jc-cr/edge_human_detection_board/docs/coral_micro_docs/dev_board_micro/Coral-Dev-Board-Micro-Altium/PCB/ALTIUM_EMBEDDED_MODELS/1206.STEP

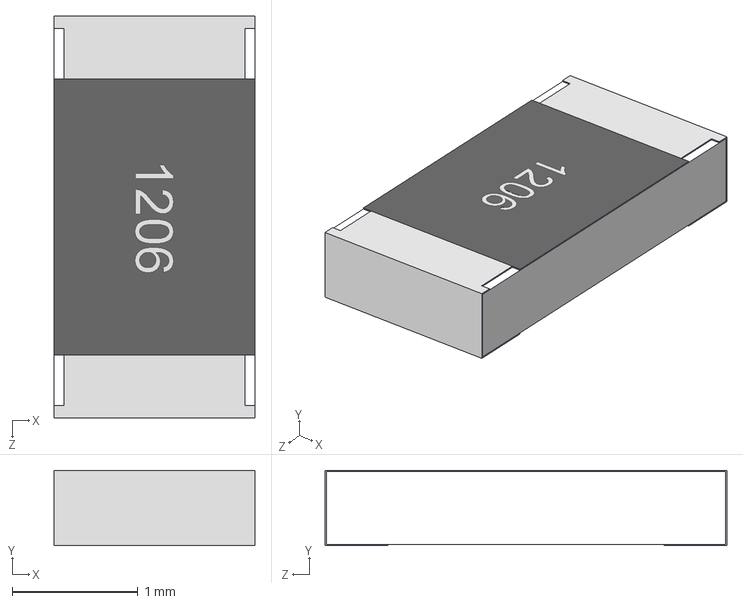
[picture p1: CAD file, 2024-11-24]
docs/coral_micro_docs/dev_board_micro/Coral-Dev-Board-Micro-Altium/PCB/ALTIUM_EMBEDDED_MODELS/1206.STEP
1.60 x 0.6 x 3.20 mm
