jc-cr/edge_human_detection_board/LIB_4684/4684/3D/4684.stp

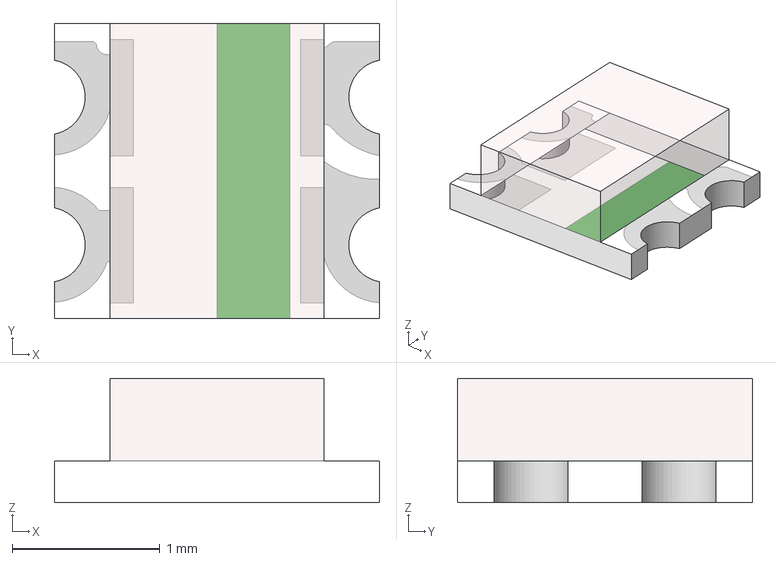
[picture p2: CAD file, 2024-12-29]
LIB_4684/4684/3D/4684.stp
2.20 x 2.00 x 0.84 mm
