jc-cr/edge_human_detection_board/LIB_VL53L8CXV0GC_1/VL53L8CXV0GC_1/3D/VL53L8CXV0GC_1.stp

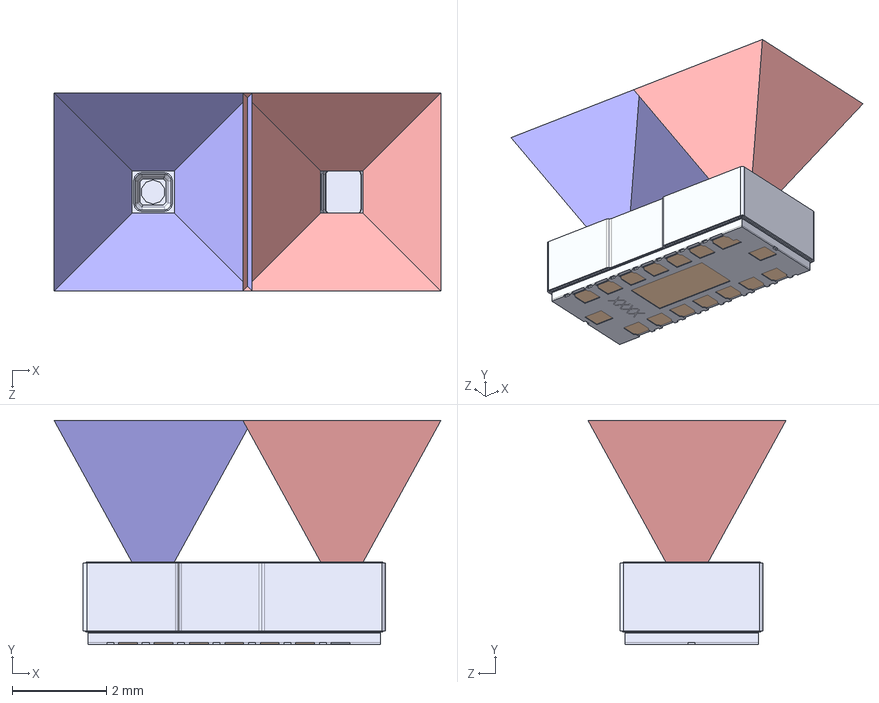
[picture p3: CAD file, 2024-12-29]
LIB_VL53L8CXV0GC_1/VL53L8CXV0GC_1/3D/VL53L8CXV0GC_1.stp
8.20 x 4.75 x 4.20 mm
VL53L8 SUBSTRATE
VL53L8 CAP
VL53L8 Rx Exclusion Cone
VL53L8 Tx Exclusion Cone
