jc-cr/edge_human_detection_board/satel-vl53l8-cad-files-step/J5866.step

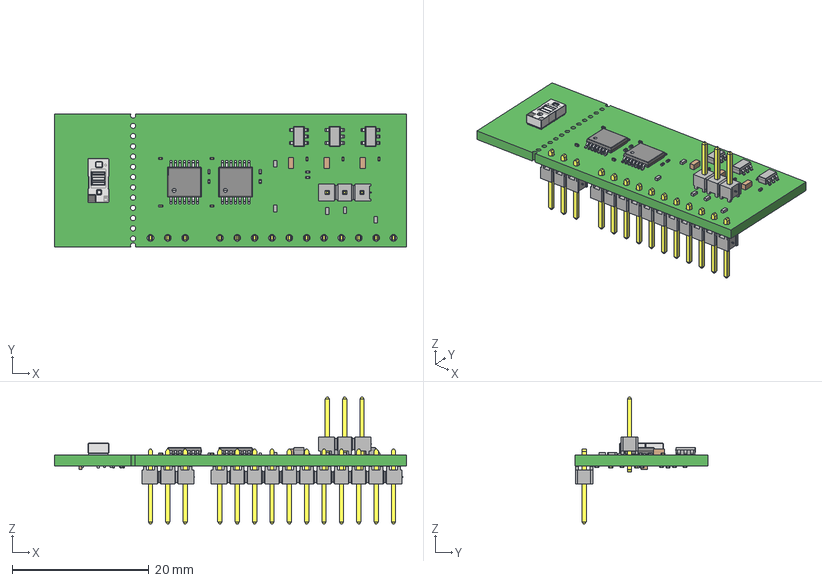
[picture p4: CAD file, 2024-11-22]
satel-vl53l8-cad-files-step/J5866.step
51.5 x 19.5 x 18.5 mm
_TSW-103-07-G-S_body x 2
_T-1S6-07-TSW-1-07-3-S x 2
Extruded x 86
User_Library-TSSOP14-1 x 2
User_Library-SOT-23-5L x 3
MZ_Plus_ES0_MODULE_ASSEMBLY
_TSW-111-07-G-S_body
_T-1S6-07-TSW-1-07-11-S
