jc-cr/edge_human_detection_board/docs/coral_micro_docs/dev_board_micro/Coral-Dev-Board-Micro-Altium/PCB/ALTIUM_EMBEDDED_MODELS/0603.STEP

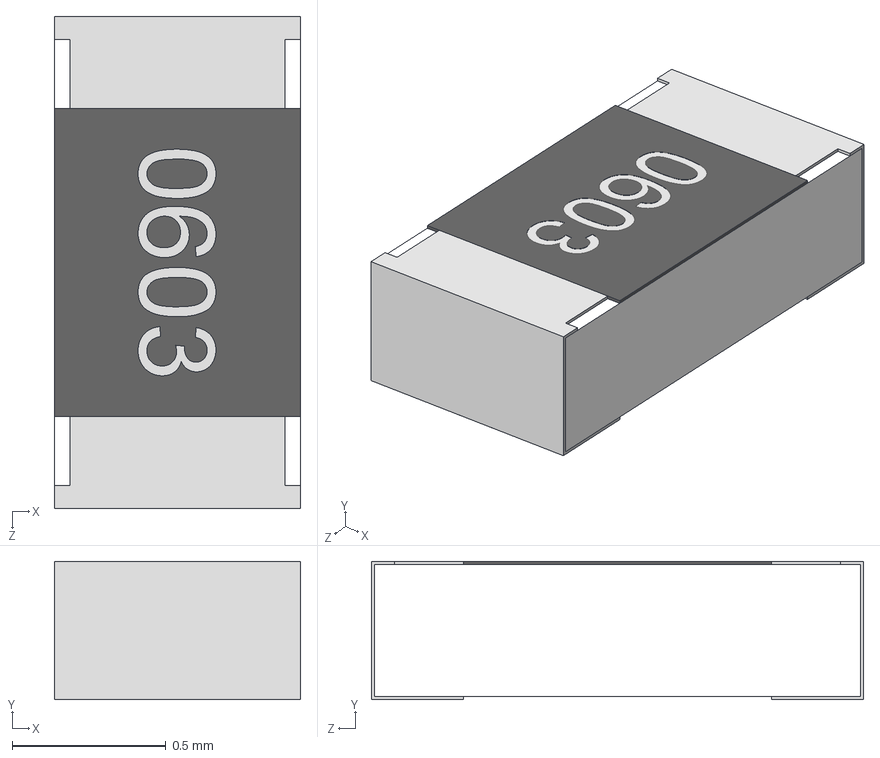
[picture p5: CAD file, 2024-11-24]
docs/coral_micro_docs/dev_board_micro/Coral-Dev-Board-Micro-Altium/PCB/ALTIUM_EMBEDDED_MODELS/0603.STEP
0.8 x 0.45 x 1.60 mm
