jc-cr/edge_human_detection_board/electricals/dev_board_micro/Coral-Dev-Board-Micro-Altium/PCB/ALTIUM_EMBEDDED_MODELS/SOD123 Default.STEP

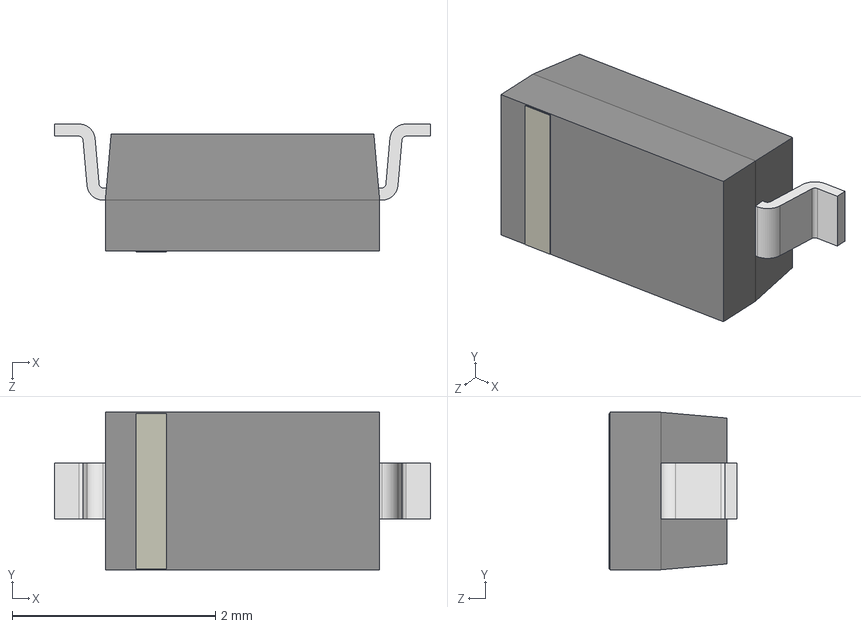
[picture p6: CAD file, 2024-11-24]
electricals/dev_board_micro/Coral-Dev-Board-Micro-Altium/PCB/ALTIUM_EMBEDDED_MODELS/SOD123 Default.STEP
3.70 x 1.55 x 1.26 mm
