jc-cr/edge_human_detection_board/docs/coral_micro_docs/dev_board_micro/Coral-Dev-Board-Micro-Altium/PCB/ALTIUM_EMBEDDED_MODELS/BGA289CP80_17X17_1400X1400X152B43.STEP

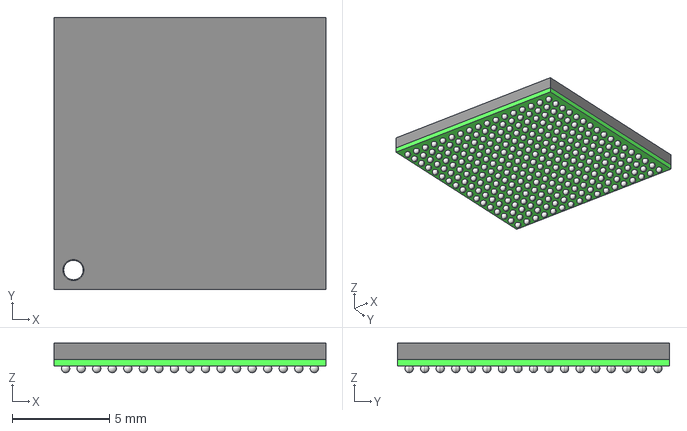
[picture p7: CAD file, 2024-11-24]
docs/coral_micro_docs/dev_board_micro/Coral-Dev-Board-Micro-Altium/PCB/ALTIUM_EMBEDDED_MODELS/BGA289CP80_17X17_1400X1400X152B43.STEP
14.0 x 14.0 x 1.52 mm
