jc-cr/edge_human_detection_board/electricals/dev_board_micro/Coral-Dev-Board-Micro-Altium/PCB/ALTIUM_EMBEDDED_MODELS/698B116W26A-661.STEP

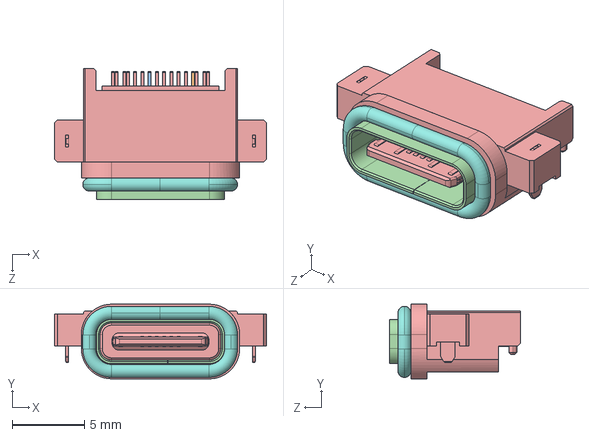
[picture p8: CAD file, 2024-11-24]
electricals/dev_board_micro/Coral-Dev-Board-Micro-Altium/PCB/ALTIUM_EMBEDDED_MODELS/698B116W26A-661.STEP
14.6 x 5.16 x 9.02 mm
698B116W26A-661
698B116W26A-661_ORING
