jc-cr/edge_human_detection_board/docs/coral_micro_docs/dev_board_micro/Coral-Dev-Board-Micro-Altium/PCB/ALTIUM_EMBEDDED_MODELS/XRCGB24M000F1H01R0.STEP

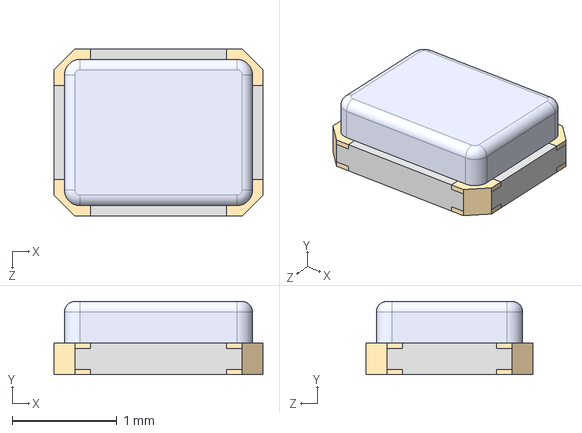
[picture p9: CAD file, 2024-11-24]
docs/coral_micro_docs/dev_board_micro/Coral-Dev-Board-Micro-Altium/PCB/ALTIUM_EMBEDDED_MODELS/XRCGB24M000F1H01R0.STEP
2.00 x 0.7 x 1.60 mm
