jc-cr/edge_human_detection_board/electricals/dev_board_micro/Coral-Dev-Board-Micro-Altium/PCB/ALTIUM_EMBEDDED_MODELS/User Library-SOT-23-5.STEP

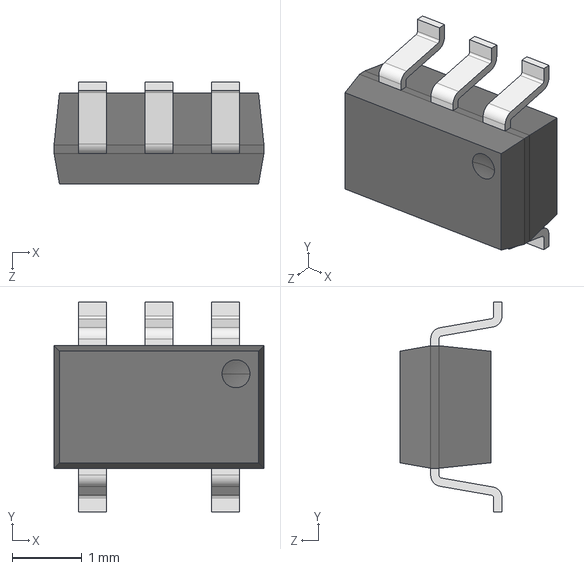
[picture p10: CAD file, 2024-11-24]
electricals/dev_board_micro/Coral-Dev-Board-Micro-Altium/PCB/ALTIUM_EMBEDDED_MODELS/User Library-SOT-23-5.STEP
3.00 x 3.00 x 1.46 mm
User Library-SOT-23-5_pin_SOT_sot-23-6_1 x 5
User Library-SOT-23-5_body_sot23-6_1
