jc-cr/edge_human_detection_board/docs/coral_micro_docs/dev_board_micro/Coral-Dev-Board-Micro-Altium/PCB/ALTIUM_EMBEDDED_MODELS/DRY0006A.stp

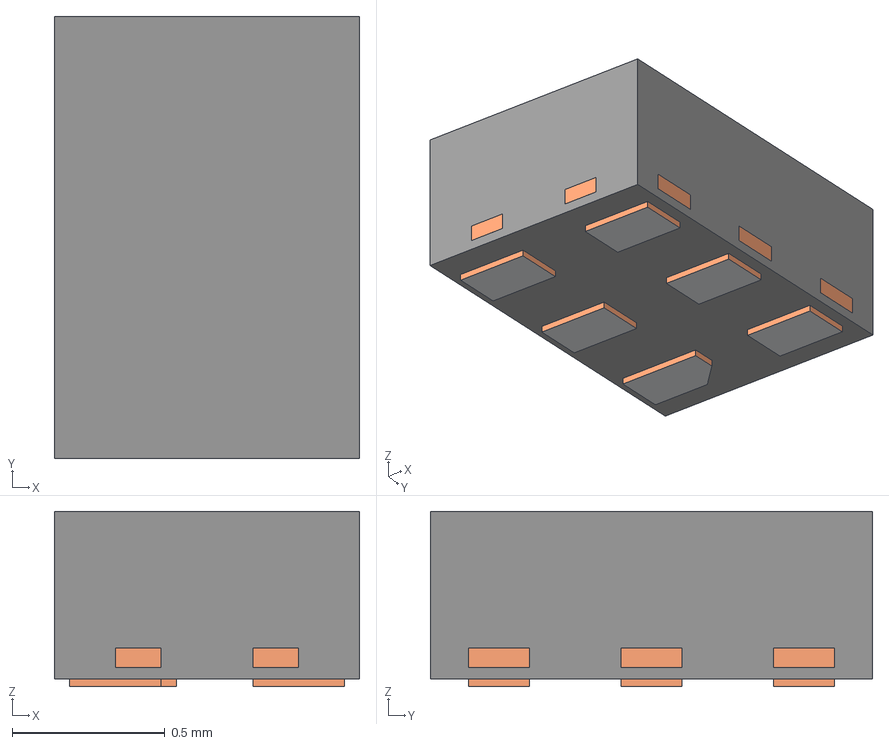
[picture p11: CAD file, 2024-11-24]
docs/coral_micro_docs/dev_board_micro/Coral-Dev-Board-Micro-Altium/PCB/ALTIUM_EMBEDDED_MODELS/DRY0006A.stp
1.00 x 1.45 x 0.575 mm
BODY-SON
FRAME-DRY0006A
PIN1-ID
