jc-cr/edge_human_detection_board/electricals/dev_board_micro/Coral-Dev-Board-Micro-Altium/PCB/ALTIUM_EMBEDDED_MODELS/SDFN4.STEP

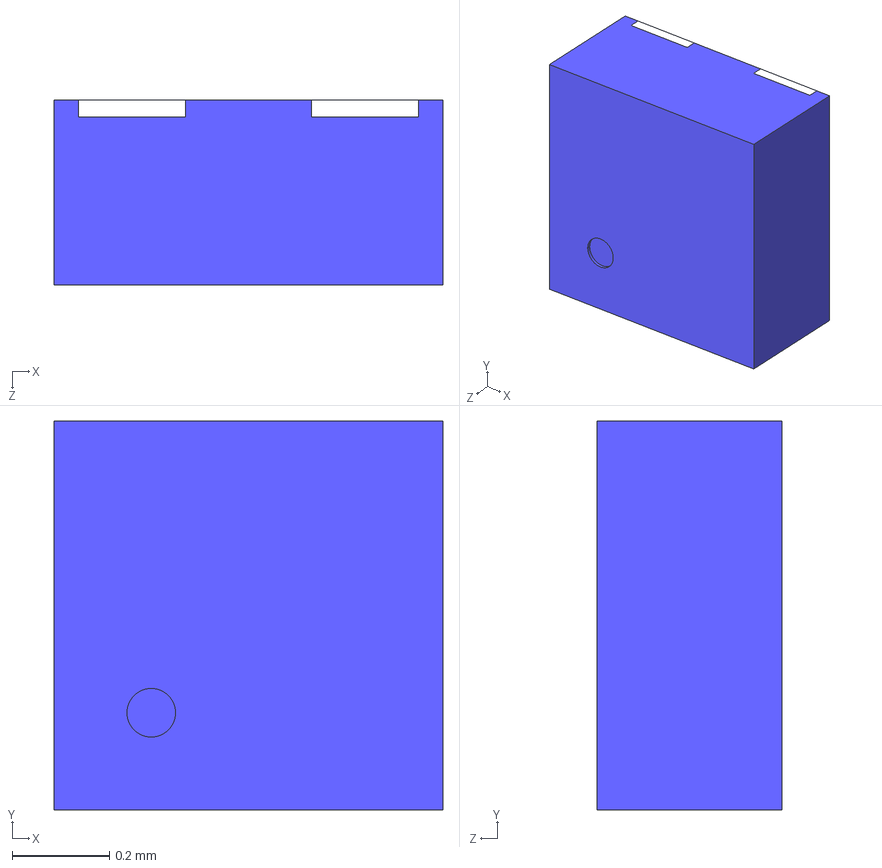
[picture p12: CAD file, 2024-11-24]
electricals/dev_board_micro/Coral-Dev-Board-Micro-Altium/PCB/ALTIUM_EMBEDDED_MODELS/SDFN4.STEP
0.8 x 0.8 x 0.38 mm
