jc-cr/edge_human_detection_board/docs/coral_micro_docs/dev_board_micro/Coral-Dev-Board-Micro-Altium/PCB/ALTIUM_EMBEDDED_MODELS/BGA12C50P4X3_206X202X65.step

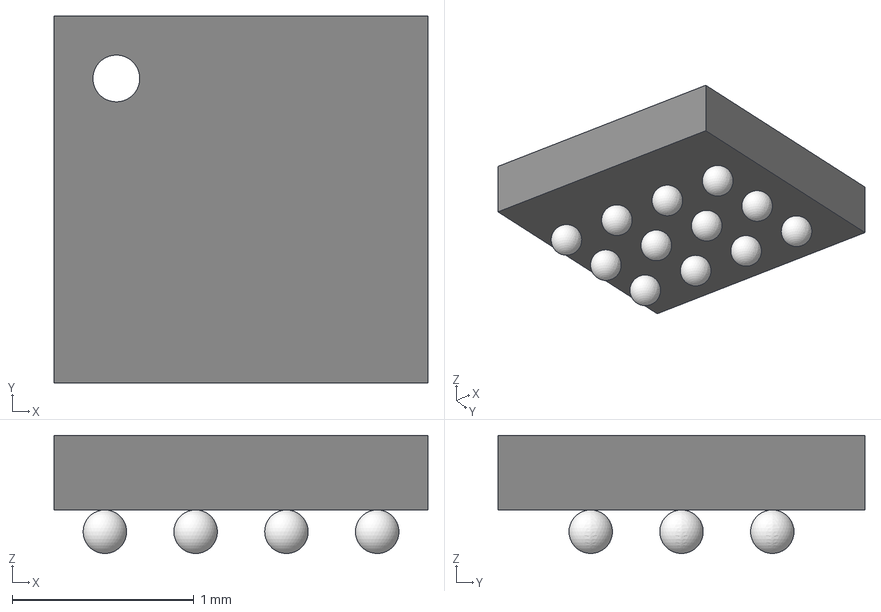
[picture p13: CAD file, 2024-11-24]
docs/coral_micro_docs/dev_board_micro/Coral-Dev-Board-Micro-Altium/PCB/ALTIUM_EMBEDDED_MODELS/BGA12C50P4X3_206X202X65.step
2.06 x 2.02 x 0.65 mm
ball x 12
