jc-cr/edge_human_detection_board/electricals/dev_board_micro/Coral-Dev-Board-Micro-Altium/PCB/ALTIUM_EMBEDDED_MODELS/VFBGA54_8X8_MRN.step

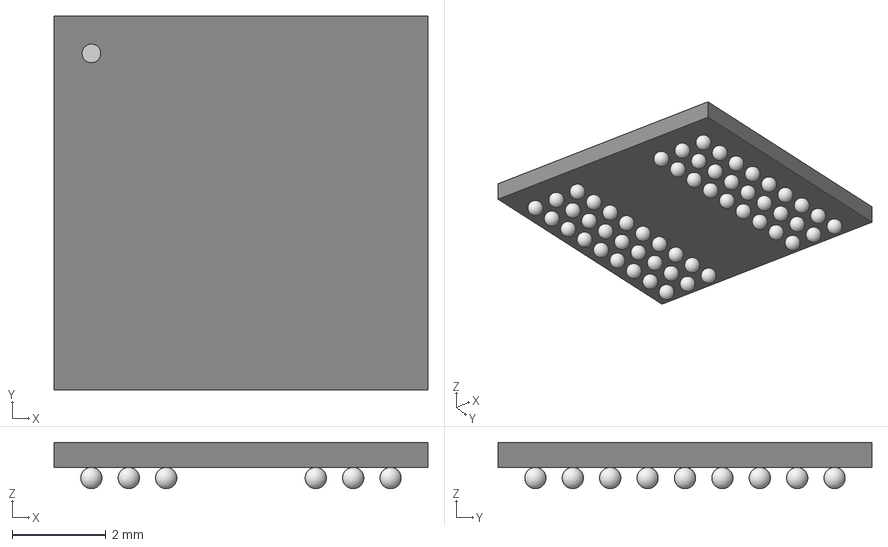
[picture p14: CAD file, 2024-11-24]
electricals/dev_board_micro/Coral-Dev-Board-Micro-Altium/PCB/ALTIUM_EMBEDDED_MODELS/VFBGA54_8X8_MRN.step
8.00 x 8.00 x 0.993 mm
