jc-cr/edge_human_detection_board/docs/coral_micro_docs/dev_board_micro/Coral-Dev-Board-Micro-Altium/PCB/ALTIUM_EMBEDDED_MODELS/QFN41P50_600X600X90L40X25T462.STEP

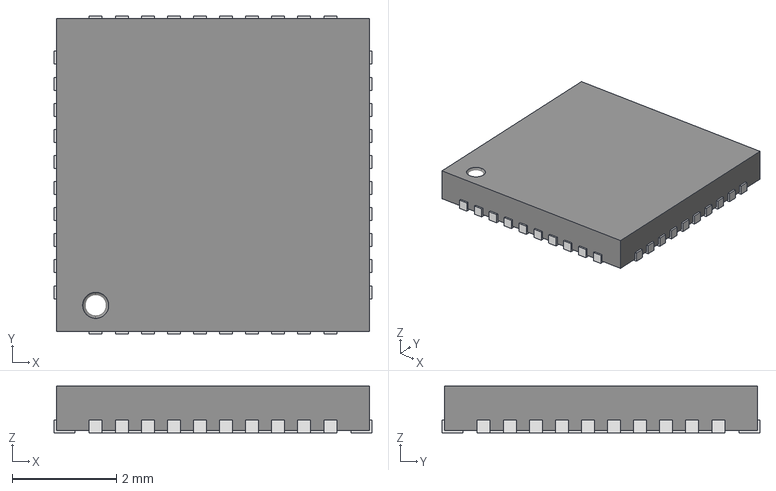
[picture p15: CAD file, 2024-11-24]
docs/coral_micro_docs/dev_board_micro/Coral-Dev-Board-Micro-Altium/PCB/ALTIUM_EMBEDDED_MODELS/QFN41P50_600X600X90L40X25T462.STEP
6.10 x 6.10 x 0.9 mm
