jc-cr/edge_human_detection_board/electricals/dev_board_micro/Coral-Dev-Board-Micro-Altium/PCB/ALTIUM_EMBEDDED_MODELS/SPK0641HT4H_Ramis_3D_Model.STEP

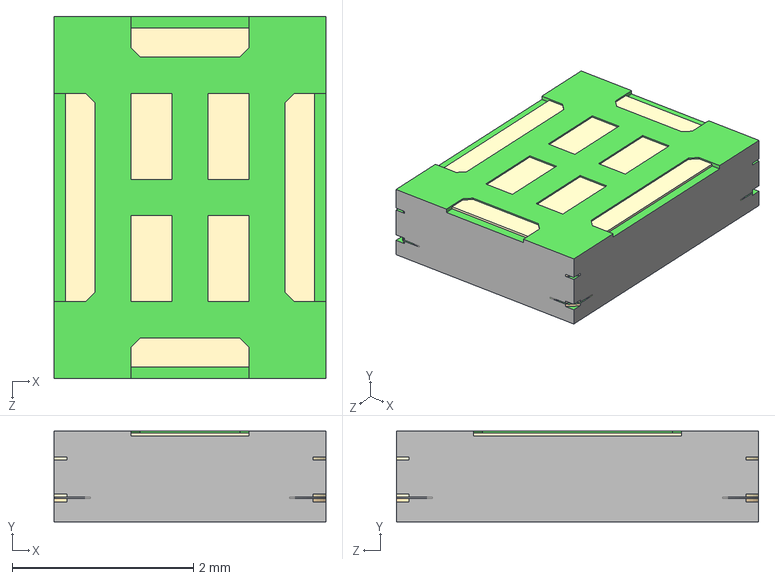
[picture p16: CAD file, 2024-11-24]
electricals/dev_board_micro/Coral-Dev-Board-Micro-Altium/PCB/ALTIUM_EMBEDDED_MODELS/SPK0641HT4H_Ramis_3D_Model.STEP
3.00 x 1.00 x 4.00 mm
