jc-cr/edge_human_detection_board/electricals/dev_board_micro/Coral-Dev-Board-Micro-Altium/PCB/ALTIUM_EMBEDDED_MODELS/CAS-D20TA--3DModel-STEP-56544.STEP

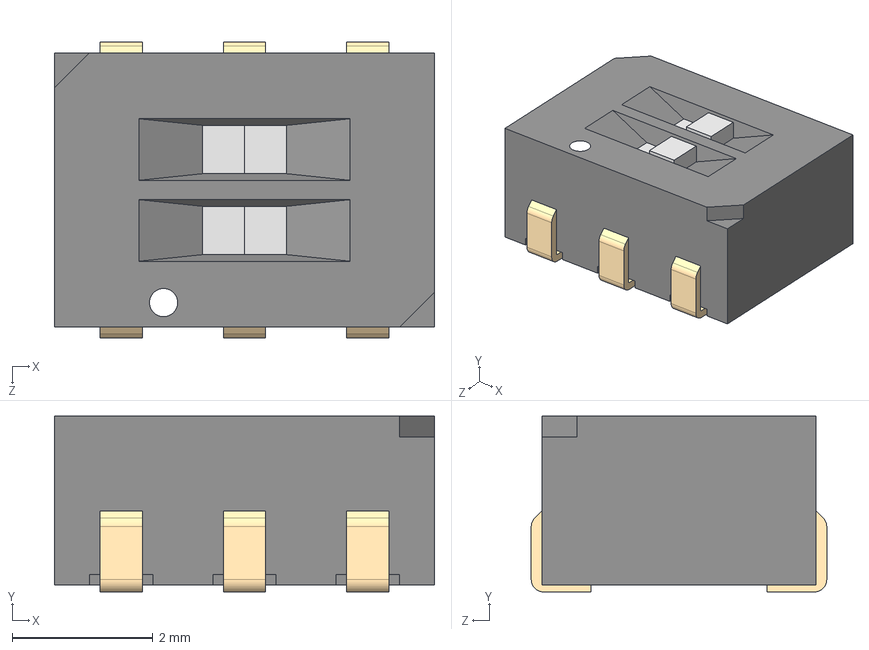
[picture p20: CAD file, 2024-11-24]
electricals/dev_board_micro/Coral-Dev-Board-Micro-Altium/PCB/ALTIUM_EMBEDDED_MODELS/CAS-D20TA--3DModel-STEP-56544.STEP
5.40 x 2.50 x 4.20 mm
