jc-cr/edge_human_detection_board/docs/coral_micro_docs/dev_board_micro/Coral-Dev-Board-Micro-Altium/PCB/ALTIUM_EMBEDDED_MODELS/74AXP1T34GMH.stp

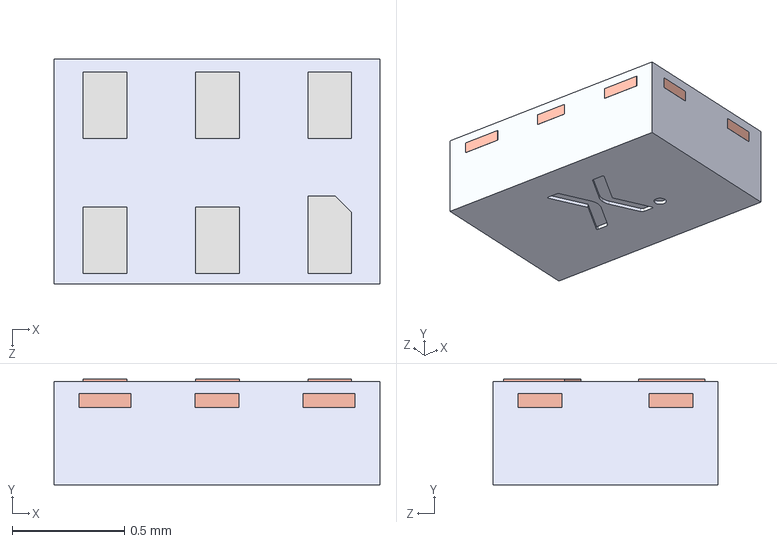
[picture p22: CAD file, 2024-11-24]
docs/coral_micro_docs/dev_board_micro/Coral-Dev-Board-Micro-Altium/PCB/ALTIUM_EMBEDDED_MODELS/74AXP1T34GMH.stp
1.45 x 0.47 x 1.00 mm
SOT886 LF
SOT886 Mold Body
