jc-cr/edge_human_detection_board/docs/coral_micro_docs/dev_board_micro/Coral-Dev-Board-Micro-Altium/PCB/ALTIUM_EMBEDDED_MODELS/PTS810SJM250SMTRLFS (TAH-1QR Equivalent).stp

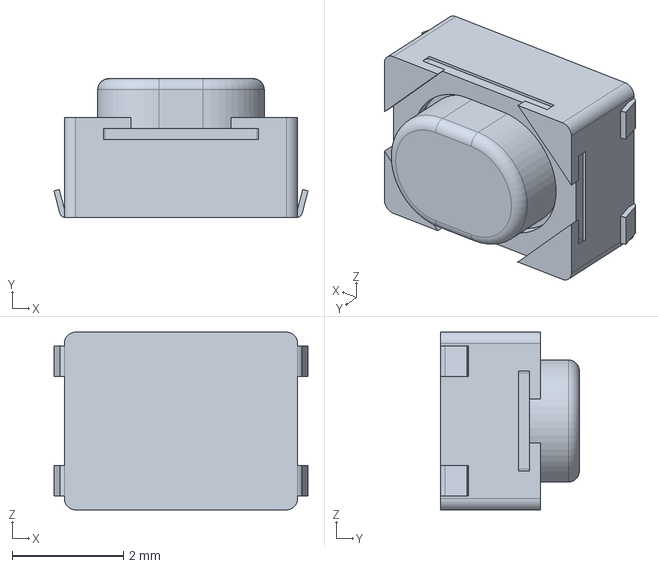
[picture p24: CAD file, 2024-11-24]
docs/coral_micro_docs/dev_board_micro/Coral-Dev-Board-Micro-Altium/PCB/ALTIUM_EMBEDDED_MODELS/PTS810SJM250SMTRLFS (TAH-1QR Equivalent).stp
4.58 x 2.50 x 3.20 mm
