jc-cr/edge_human_detection_board/electricals/dev_board_micro/Coral-Dev-Board-Micro-Altium/PCB/ALTIUM_EMBEDDED_MODELS/QFN50P1500X1000X150-88N.step

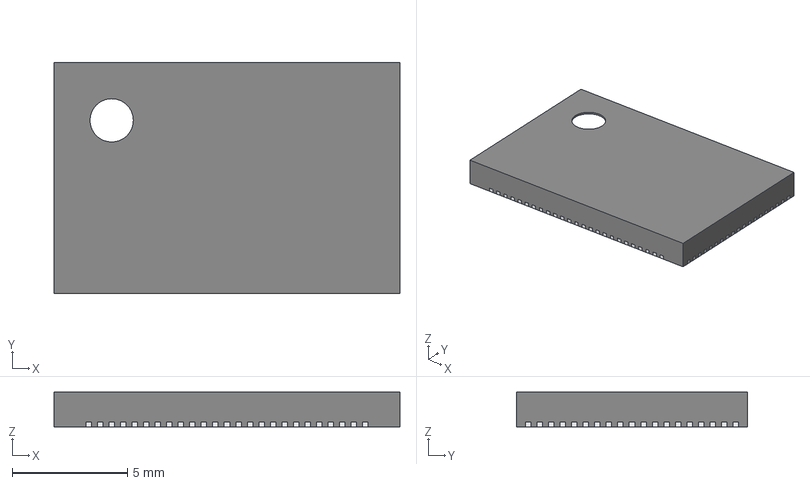
[picture p25: CAD file, 2024-11-24]
electricals/dev_board_micro/Coral-Dev-Board-Micro-Altium/PCB/ALTIUM_EMBEDDED_MODELS/QFN50P1500X1000X150-88N.step
15.0 x 10.0 x 1.50 mm
