jc-cr/edge_human_detection_board/(list of files, cad)

Other CAD files:
LIB_4684/4684/Allegro/4684.psm
LIB_4684/4684/DEHDL/4684/chips/chips.prt
LIB_VL53L8CXV0GC_1/VL53L8CXV0GC_1/Allegro/vl53l8cxv0gc1.psm
LIB_VL53L8CXV0GC_1/VL53L8CXV0GC_1/DEHDL/vl53l8cxv0gc_1/chips/chips.prt
docs/coral_micro_docs/dev_board_micro/Coral-Dev-Board-Micro-Altium/PCB/ALTIUM_EMBEDDED_MODELS/5037722410.stp
docs/coral_micro_docs/dev_board_micro/Coral-Dev-Board-Micro-Altium/PCB/ALTIUM_EMBEDDED_MODELS/74404041047_Download_STP_WE-LQS-4012_rev1.stp
electricals/dev_board_micro/Coral-Dev-Board-Micro-Altium/PCB/ALTIUM_EMBEDDED_MODELS/5037722410.stp
electricals/dev_board_micro/Coral-Dev-Board-Micro-Altium/PCB/ALTIUM_EMBEDDED_MODELS/74404041047_Download_STP_WE-LQS-4012_rev1.stp
