jc-cr/edge_human_detection_board/(list of files, drawings)

Other design files:
docs/coral_micro_docs/dev_board_micro/Coral-Dev-Board-Micro-Altium/Coral Dev Board Micro.PrjPcb
docs/coral_micro_docs/dev_board_micro/Coral-Dev-Board-Micro-Altium/SCH/01 COVER.SchDoc
docs/coral_micro_docs/dev_board_micro/Coral-Dev-Board-Micro-Altium/SCH/02 BLOCK DIAGRAM.SchDoc
docs/coral_micro_docs/dev_board_micro/Coral-Dev-Board-Micro-Altium/SCH/03 POWER DIAGRAM.SchDoc
docs/coral_micro_docs/dev_board_micro/Coral-Dev-Board-Micro-Altium/SCH/04 MAIN POWER.SchDoc
docs/coral_micro_docs/dev_board_micro/Coral-Dev-Board-Micro-Altium/SCH/05 MIMXRT1170 PART1.SchDoc
docs/coral_micro_docs/dev_board_micro/Coral-Dev-Board-Micro-Altium/SCH/05 POWER DOMAIN.SchDoc
docs/coral_micro_docs/dev_board_micro/Coral-Dev-Board-Micro-Altium/SCH/06 MIMXRT1170 PART2.SchDoc
docs/coral_micro_docs/dev_board_micro/Coral-Dev-Board-Micro-Altium/SCH/07 MIMXRT1170 PART3.SchDoc
docs/coral_micro_docs/dev_board_micro/Coral-Dev-Board-Micro-Altium/SCH/08 B2B.SchDoc
docs/coral_micro_docs/dev_board_micro/Coral-Dev-Board-Micro-Altium/SCH/09 Parallel Camera.SchDoc
docs/coral_micro_docs/dev_board_micro/Coral-Dev-Board-Micro-Altium/SCH/10 FLASH_BOOT.SchDoc
docs/coral_micro_docs/dev_board_micro/Coral-Dev-Board-Micro-Altium/SCH/11 SDRAM.SchDoc
docs/coral_micro_docs/dev_board_micro/Coral-Dev-Board-Micro-Altium/SCH/12 DMIC.SchDoc
docs/coral_micro_docs/dev_board_micro/Coral-Dev-Board-Micro-Altium/SCH/13 USB.SchDoc
docs/coral_micro_docs/dev_board_micro/Coral-Dev-Board-Micro-Altium/SCH/14 TPU.SchDoc
docs/coral_micro_docs/dev_board_micro/Coral-Dev-Board-Micro-Altium/SCH/15 BOOT.SchDoc
docs/coral_micro_docs/dev_board_micro/Coral-Dev-Board-Micro-Altium/SCH/16 INTERFACE.SchDoc
docs/coral_micro_docs/dev_board_micro/Coral-Dev-Board-Micro-Altium/SCH/17 Revision History.SchDoc
electricals/dev_board_micro/Coral-Dev-Board-Micro-Altium/Coral Dev Board Micro.PrjPcb
electricals/dev_board_micro/Coral-Dev-Board-Micro-Altium/SCH/01 COVER.SchDoc
electricals/dev_board_micro/Coral-Dev-Board-Micro-Altium/SCH/02 BLOCK DIAGRAM.SchDoc
electricals/dev_board_micro/Coral-Dev-Board-Micro-Altium/SCH/03 POWER DIAGRAM.SchDoc
electricals/dev_board_micro/Coral-Dev-Board-Micro-Altium/SCH/04 MAIN POWER.SchDoc
electricals/dev_board_micro/Coral-Dev-Board-Micro-Altium/SCH/05 MIMXRT1170 PART1.SchDoc
electricals/dev_board_micro/Coral-Dev-Board-Micro-Altium/SCH/05 POWER DOMAIN.SchDoc
electricals/dev_board_micro/Coral-Dev-Board-Micro-Altium/SCH/06 MIMXRT1170 PART2.SchDoc
electricals/dev_board_micro/Coral-Dev-Board-Micro-Altium/SCH/07 MIMXRT1170 PART3.SchDoc
electricals/dev_board_micro/Coral-Dev-Board-Micro-Altium/SCH/08 B2B.SchDoc
electricals/dev_board_micro/Coral-Dev-Board-Micro-Altium/SCH/09 Parallel Camera.SchDoc
electricals/dev_board_micro/Coral-Dev-Board-Micro-Altium/SCH/10 FLASH_BOOT.SchDoc
electricals/dev_board_micro/Coral-Dev-Board-Micro-Altium/SCH/11 SDRAM.SchDoc
electricals/dev_board_micro/Coral-Dev-Board-Micro-Altium/SCH/12 DMIC.SchDoc
electricals/dev_board_micro/Coral-Dev-Board-Micro-Altium/SCH/13 USB.SchDoc
electricals/dev_board_micro/Coral-Dev-Board-Micro-Altium/SCH/14 TPU.SchDoc
electricals/dev_board_micro/Coral-Dev-Board-Micro-Altium/SCH/15 BOOT.SchDoc
electricals/dev_board_micro/Coral-Dev-Board-Micro-Altium/SCH/16 INTERFACE.SchDoc
electricals/dev_board_micro/Coral-Dev-Board-Micro-Altium/SCH/17 Revision History.SchDoc
LIB_4684/4684/Altium/4684.PcbLib
LIB_4684/4684/Altium/4684.SchLib
LIB_VL53L8CXV0GC_1/VL53L8CXV0GC_1/Altium/VL53L8CXV0GC1.PcbLib
LIB_VL53L8CXV0GC_1/VL53L8CXV0GC_1/Altium/VL53L8CXV0GC_1.SchLib
