jc-cr/edge_human_detection_board/edge_human_detection_board.kicad_pcb

## KiCad design edge_human_detection_board.kicad_pcb (2025-04-13)

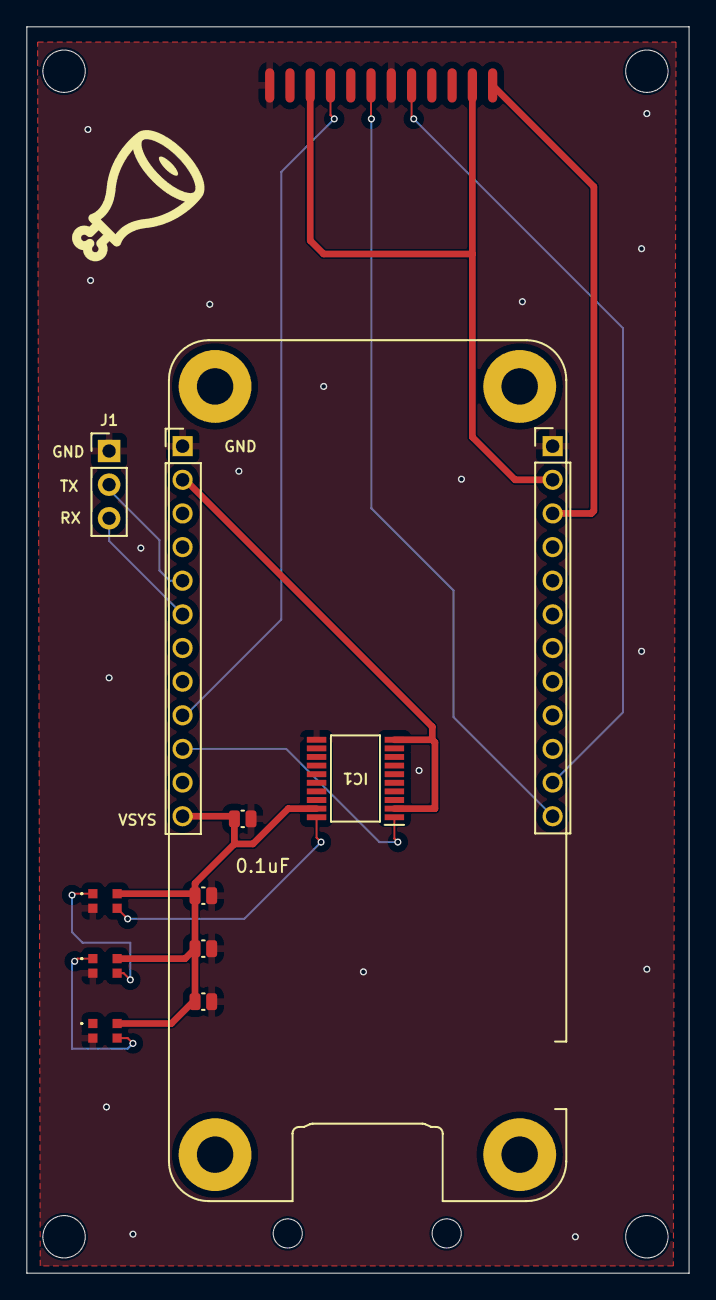
[picture p28: board edge_human_detection_board.kicad_pcb from above]

Board: 4 copper layers, 50.0 x 94.1 mm, 11 parts (0 on the bottom side), 14 nets.

Parts:
C1, C2, C3, C4: 0.1uF; C_0504_1310Metric_Pad0.83x1.28mm_HandSolder
D2, D3, D4: WS2812B; 4684
IC1: TXB0108PWR; SOP65P640X120-20N
J1: Conn_01x03_Socket; PinHeader_1x03_P2.54mm_Vertical
U1: coral_micro_board_mating
U2: SATEL-VL53L8A

Connections:
/Coral Micro Breakouts/+1.8VDC_RGB: IC1.2 (VCCA), IC1.10 (OE), U1.14 (1.8V)
/Coral Micro Breakouts/+1.8VDC_TOF: U1.2 (1.8V), U2.3 (CORE_1V8), U2.11 (IOVDD)
/Coral Micro Breakouts/+3.3VDC: U1.3 (3.3V), U2.12 (AVDD)
/Coral Micro Breakouts/+5VDC: C1.2, C2.2, C3.2, C4.2, D2.4 (VDD), D3.4 (VDD), D4.4 (VDD), IC1.19 (VCCB), U1.24 (VSYS)
/Coral Micro Breakouts/DEBUG_RX: J1.3, U1.18 (UART6_RX)
/Coral Micro Breakouts/DEBUG_TX: J1.2, U1.17 (UART6_TX)
/Coral Micro Breakouts/PWM_1: U1.21 (PWM_B), U2.4 (LPn)
/Coral Micro Breakouts/SCL: U1.11 (I2C1_SCL), U2.8 (SCL)
/Coral Micro Breakouts/SDA: U1.12 (I2C1_SDA), U2.6 (SDA)
/RGB Signalling/SIG_IN_PWM0: IC1.1 (A1), U1.22 (PWM_A)
/RGB Signalling/SIG_IN_RGB1: D2.3 (DI), IC1.20 (B1)
/RGB Signalling/SIG_IN_RGB2: D2.1 (DO), D3.3 (DI)
/RGB Signalling/SIG_IN_RGB3: D3.1 (DO), D4.3 (DI)
GND: C1.1, C2.1, C3.1, C4.1, D2.2 (GND), D3.2 (GND), D4.2 (GND), IC1.11 (GND), J1.1, U1.1 (GND), U1.13 (GND), U2.1 (DUT_GND), U2.7 (I2C_N)
