jc-cr/edge_human_detection_board/tof_module/tof_module.kicad_pcb

## KiCad design tof_module/tof_module.kicad_pcb (2025-02-22)

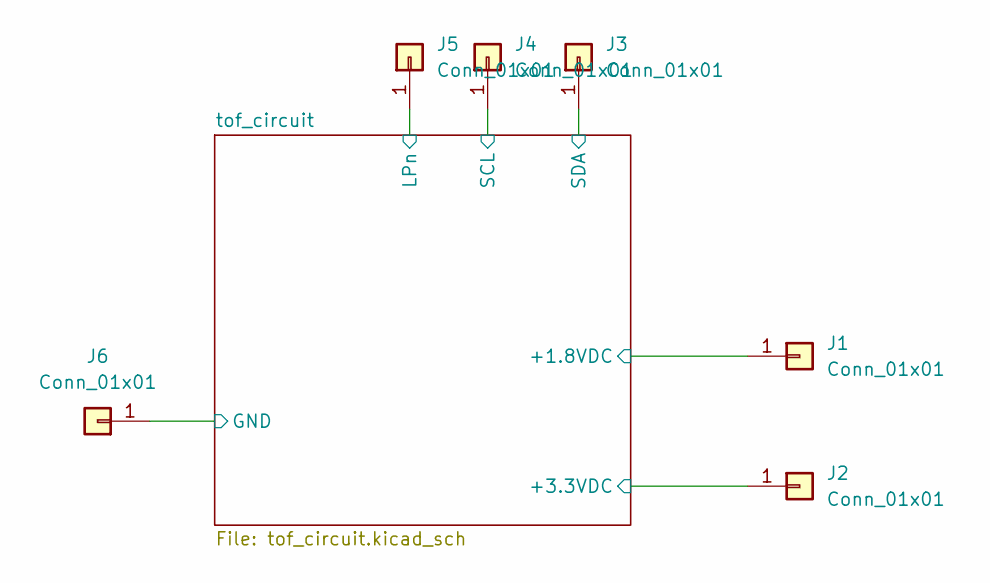
[picture p29: schematic tof_module.kicad_sch]

Parts:
J1, J2, J3, J4, J5, J6: Conn_01x01; spec_header

Connections:
/tof_circuit/AVDD: J2.1; also elsewhere on the board
/tof_circuit/CORE_1V8: J1.1; also elsewhere on the board
/tof_circuit/LPn: J5.1; also elsewhere on the board
/tof_circuit/SCL: J4.1; also elsewhere on the board
/tof_circuit/SDA: J3.1; also elsewhere on the board
GND: J6.1; also elsewhere on the board

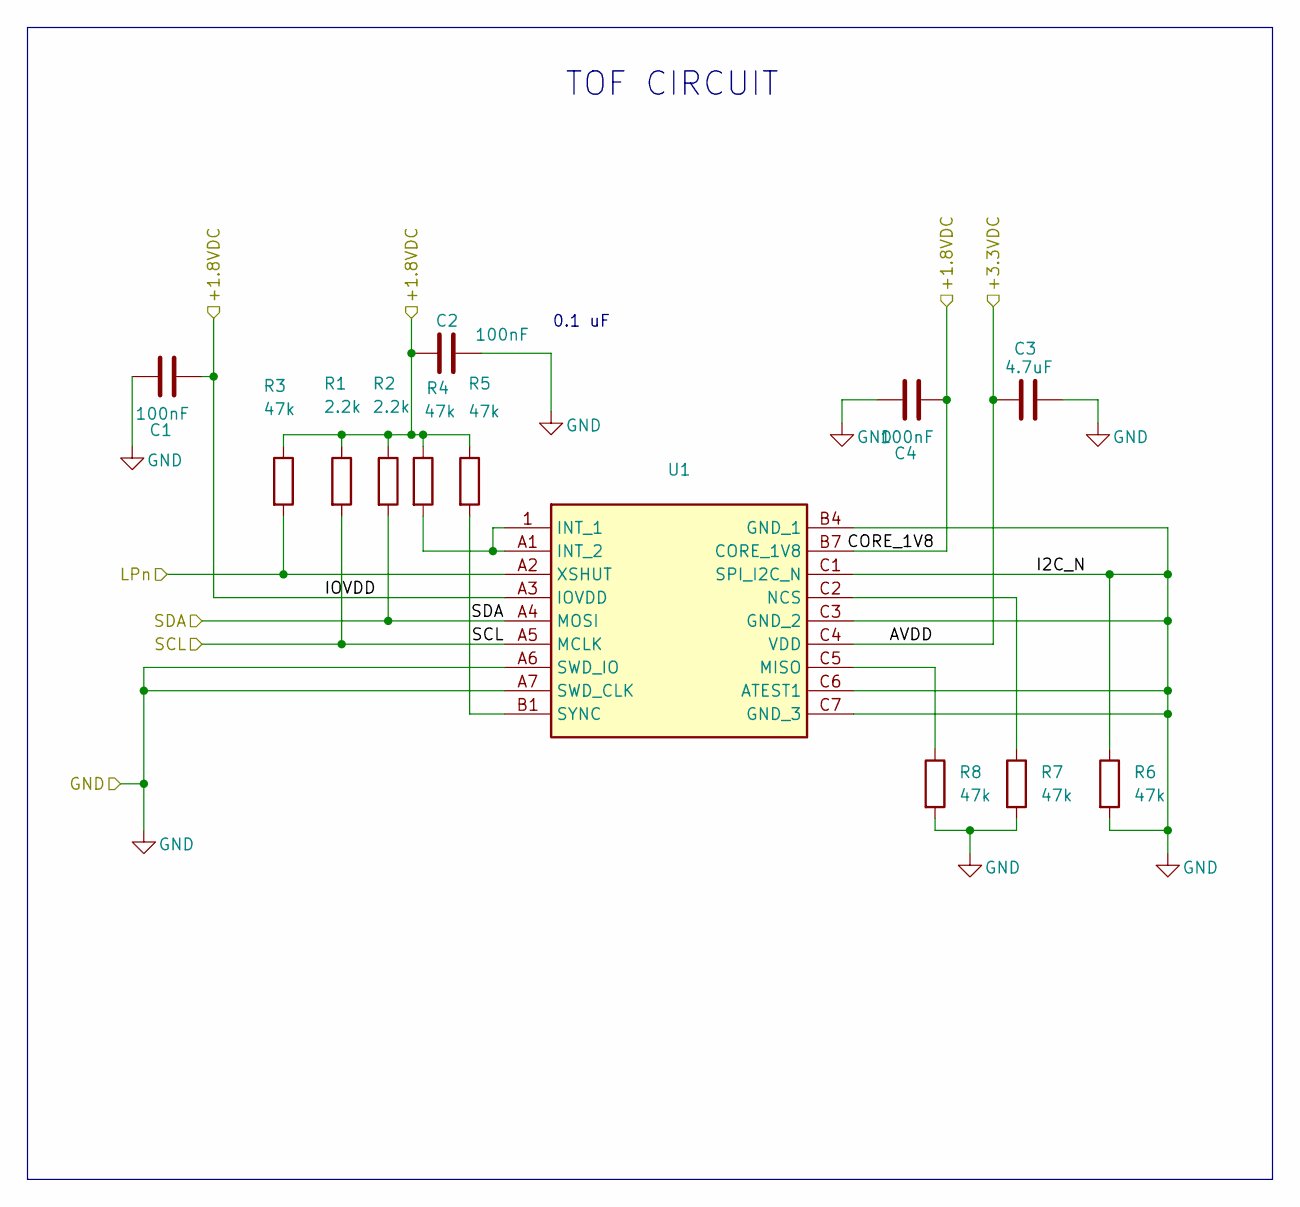
[picture p30: schematic tof_circuit.kicad_sch]

Parts:
C1, C2, C4: 100nF; C_0201_0603Metric_Pad0.64x0.40mm_HandSolder
C3: 4.7uF; C_0201_0603Metric_Pad0.64x0.40mm_HandSolder
R1, R2: 2.2k; R_0603_1608Metric_Pad0.98x0.95mm_HandSolder
R3, R4, R5, R6, R7, R8: 47k; R_0603_1608Metric_Pad0.98x0.95mm_HandSolder
U1: VL53L8CXV0GC1; Mouser Part Number 511-VL53L8CXV0GC/1

Connections:
/tof_circuit/AVDD: C3.1, U1.C4 (VDD); also elsewhere on the board
/tof_circuit/CORE_1V8: C1.1, C2.2, C4.1, R1.1, R2.1, R3.1, R4.1, R5.1, U1.A3 (IOVDD), U1.B7 (CORE_1V8); also elsewhere on the board
/tof_circuit/LPn: R3.2, U1.A2 (XSHUT); also elsewhere on the board
/tof_circuit/SCL: R1.2, U1.A5 (MCLK); also elsewhere on the board
/tof_circuit/SDA: R2.2, U1.A4 (MOSI); also elsewhere on the board
GND: C1.2, C2.1, C3.2, C4.2, R6.1, R6.2, R7.2, R8.2, U1.A6 (SWD_IO), U1.A7 (SWD_CLK), U1.B4 (GND_1), U1.C1 (SPI_I2C_N), U1.C3 (GND_2), U1.C6 (ATEST1), U1.C7 (GND_3); also elsewhere on the board
unnamed: R4.2, U1.1 (INT_1), U1.A1 (INT_2)
unnamed: R8.1, U1.C5 (MISO)
unnamed: R7.1, U1.C2 (NCS)
unnamed: R5.2, U1.B1 (SYNC)

Notes on the sheet:
TOF CIRCUIT
0.1 uF

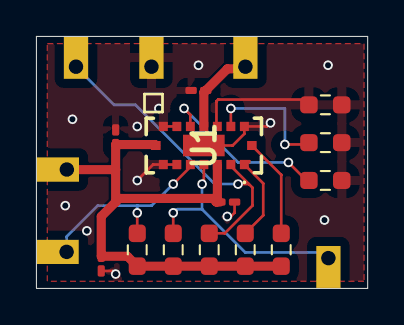
[picture p31: board tof_module.kicad_pcb from above]

Board: 2 copper layers, 18.4 x 14.0 mm, 19 parts (0 on the bottom side), 10 nets.
