jc-cr/edge_human_detection_board/(commit log)

2024-11-24 working on board
    [01 COVER.SchDoc, 02 BLOCK DIAGRAM.SchDoc, 0201 (0603) Resistor.step, 03 POWER DIAGRAM.SchDoc, 04 MAIN POWER.SchDoc, 0402.STEP, 05 MIMXRT1170 PART1.SchDoc, 05 POWER DOMAIN.SchDoc]
2024-11-24 made board
    [coral_micro_breakout.kicad_sch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]
2024-12-29 working on revisions
    [4684.PcbLib, 4684.SchLib, 4684.psm, 4684.stp, EDI2CAP.CFG, VL53L8CXV0GC1.PcbLib, VL53L8CXV0GC_1.SchLib, VL53L8CXV0GC_1.stp]
2025-01-13 Fab v
    [edge_human_detection_board-B_Mask.gbr, edge_human_detection_board-B_Paste.gbr, edge_human_detection_board-B_Silkscreen.gbr, edge_human_detection_board-Edge_Cuts.gbr, edge_human_detection_board-F_Mask.gbr, edge_human_detection_board-F_Paste.gbr, edge_human_detection_board-F_Silkscreen.gbr, edge_human_detection_board-GND_PLANE1.gbr]
2025-02-22 not working, reverting to old design
    [01 COVER.SchDoc, 02 BLOCK DIAGRAM.SchDoc, 0201 (0603) Resistor.step, 03 POWER DIAGRAM.SchDoc, 04 MAIN POWER.SchDoc, 0402.STEP, 05 MIMXRT1170 PART1.SchDoc, 05 POWER DOMAIN.SchDoc]
2025-02-22 latest updates, up to v2
    [01 COVER.SchDoc, 02 BLOCK DIAGRAM.SchDoc, 0201 (0603) Resistor.step, 03 POWER DIAGRAM.SchDoc, 04 MAIN POWER.SchDoc, 0402.STEP, 05 MIMXRT1170 PART1.SchDoc, 05 POWER DOMAIN.SchDoc]
