jc-cr/edge_human_detection_board/(notices)

Notices in the files:
electricals/dev_board_micro/Coral-Dev-Board-Micro-Altium/PCB/ALTIUM_EMBEDDED_MODELS/QFN41P50_600X600X90L40X25T462.STEP:
'©2017 PCB Libraries, Inc.',
